Safecast/bGeigie-Raku/hardware/kicad/bGeigieRakuM5/M5_board.jpg

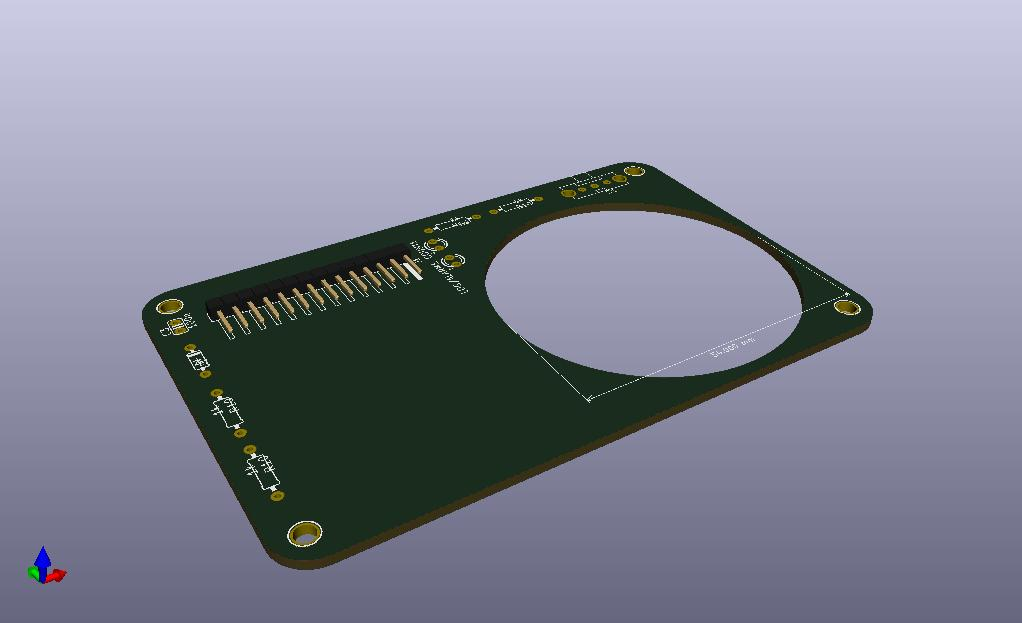
hardware/kicad/bGeigieRakuM5/M5_board.jpg
