Safecast/bGeigie-Raku/hardware/kicad/bGeigieRakuM5/M5_boardfire.png

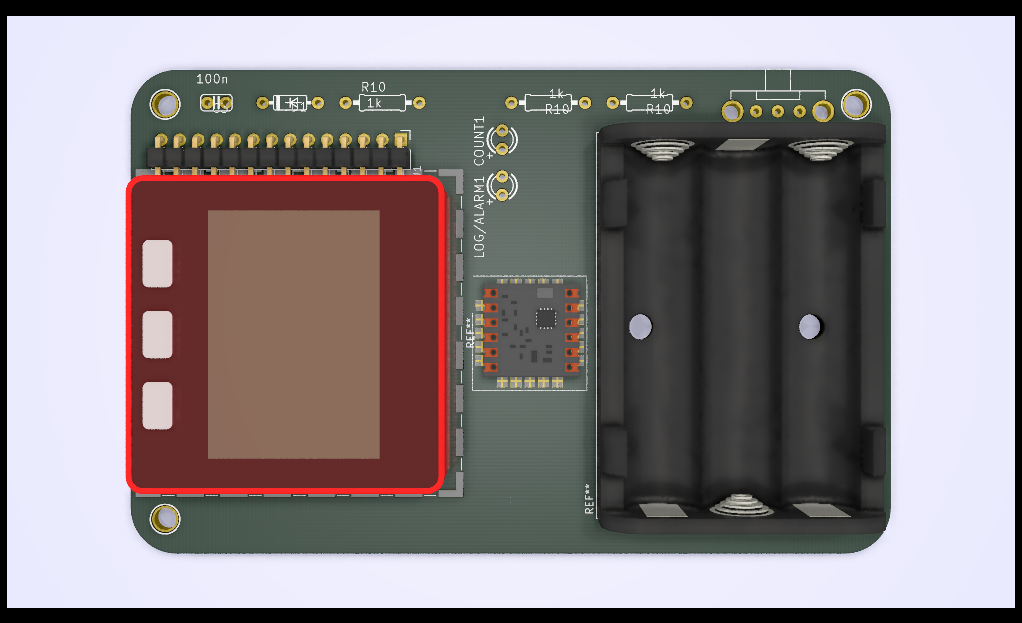
hardware/kicad/bGeigieRakuM5/M5_boardfire.png
