Safecast/bGeigie-Raku/hardware/kicad/bGeigieRakuM5/M5_board1.jpg

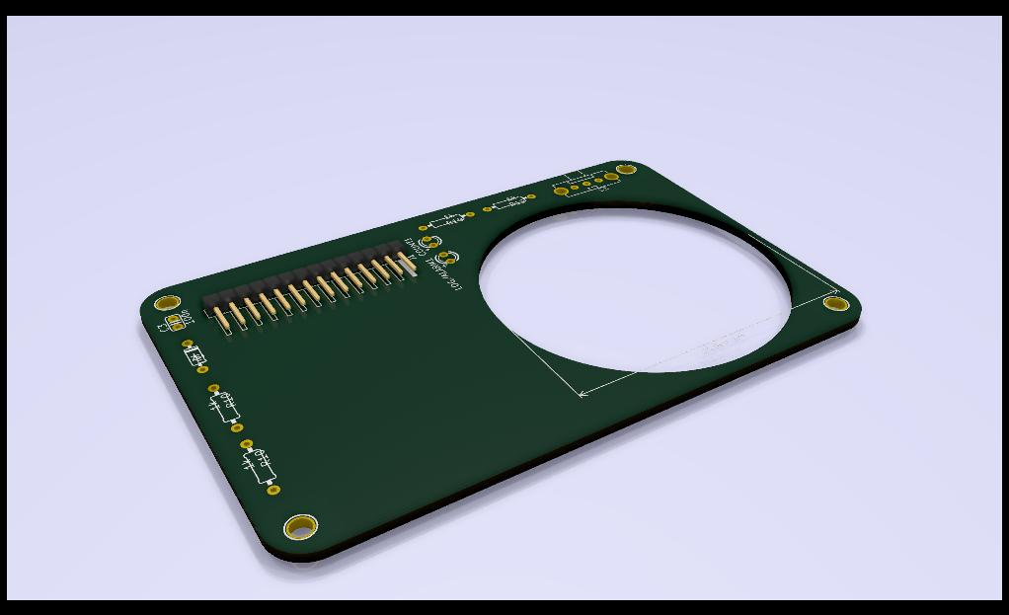
hardware/kicad/bGeigieRakuM5/M5_board1.jpg
