Safecast/bGeigie-Raku/hardware/kicad/bGeigieRakuM5/M5_board fire 1.jpg

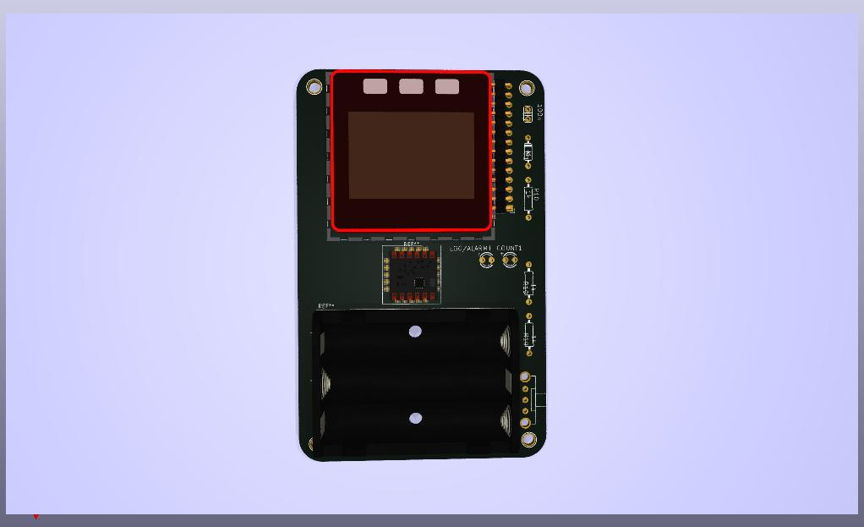
hardware/kicad/bGeigieRakuM5/M5_board fire 1.jpg
