Safecast/bGeigie-Raku/hardware/kicad/bGeigieRakuM5/M5_board fire.jpg

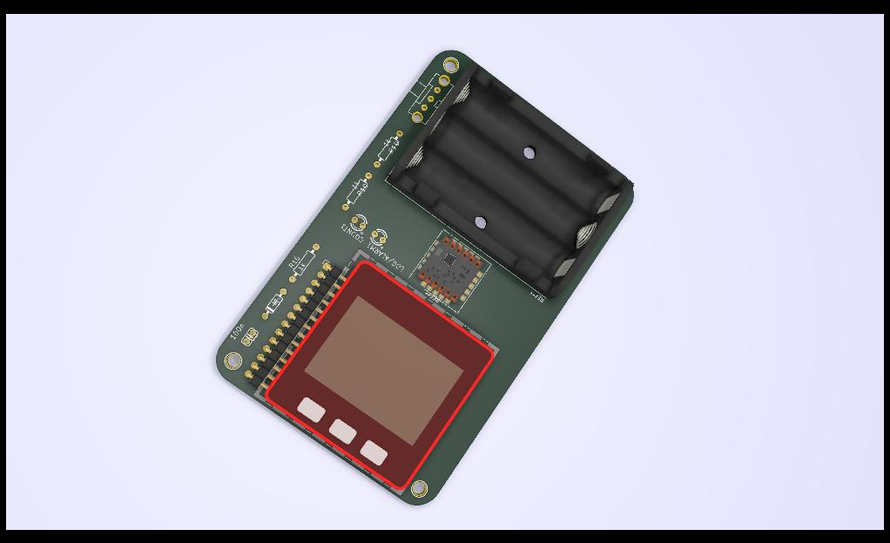
hardware/kicad/bGeigieRakuM5/M5_board fire.jpg
