Safecast/bGeigie-Raku/hardware/kicad/bGeigieRakuM5/M5_board_AAA.jpg

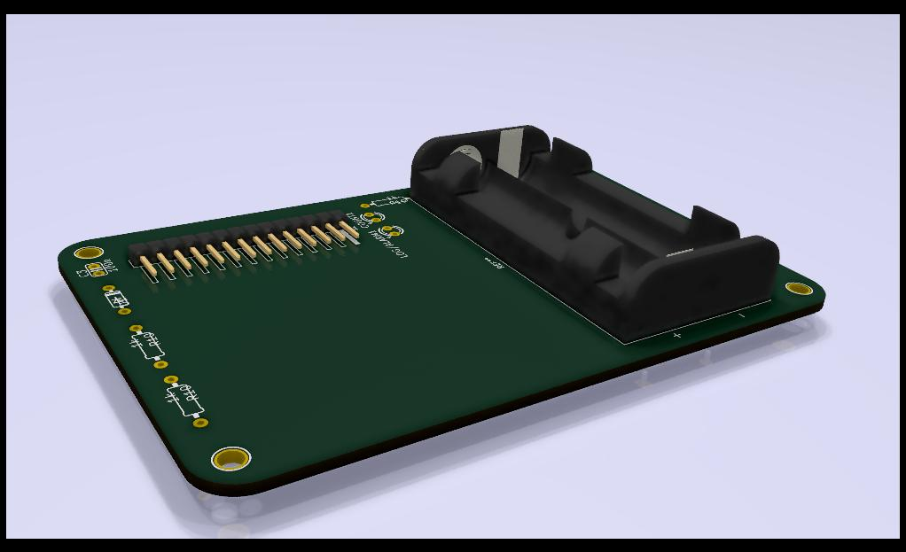
hardware/kicad/bGeigieRakuM5/M5_board_AAA.jpg
