Safecast/bGeigie-Raku/(threads)

Thread 13 (2021-03-20):

Message for terminal at startup

robouden, 2021-03-20:
Current firmware message at start up indicates a now existing config file?

_rst:0x1 (POWERON_RESET),boot:0x17 (SPI_FAST_FLASH_BOOT)
configsip: 0, SPIWP:0xee
clk_drv:0x00,q_drv:0x00,d_drv:0x00,cs0_drv:0x00,hd_drv:0x00,wp_drv:0x00
mode:DIO, clock div:2
load:0x3fff0018,len:4
load:0x3fff001c,len:1044
load:0x40078000,len:10124
load:0x40080400,len:5828
entry 0x400806a8
M5Stack initializing...O�␀Failed to read config from file_

Thread 15 (2021-04-04):

Battery level reading from LiPo

robouden, 2021-04-04:
Currently, the code from Robin is reading the status from the IP5306. But that is very primitive only 4 levels.
On the hardware side, G36 is connected the same way the bGeigieNano is connected.

A much nicer way for reading the correct voltage and the calculating the approximated charge would be much nicer.

robouden, 2023-03-13:
M5StackCore 2 modules fixes the issues with new power management chip.

Thread 23 (2022-03-10):

Setup WiFi and BLE connections a la bGeigieCast

robouden, 2022-03-10:
Needed for communication as fixed devices and for phones/tablet displaying the data.

Thread 26 (2022-03-26):

Check for movement detection on M5Stack Grey for dimming screen automatically to save power.

robouden, 2022-03-26:
For information about movement, detection:https://www.gwendesign.ch/kb/m5stack/m5stack/#wake-on-motion-wom-using-mpu6886-interrupt

robouden, 2022-03-26:
https://www.gwendesign.ch/kb/m5stack/m5stack/#wake-on-motion-wom-using-mpu6886-interrupt

Closed 2023-08-10.

Thread 27 (2023-03-09):

Cleanup old battery management source files, not relevant to M5 Core2

louisbertrand, 2023-03-09:
The file battery.cpp that defines the class BatteryMonitorIP5306 is no longer needed because M5 Core2 uses the AXP192 power management IC instead of the IP5306 the original M5 Core.
The Core2 library defines its own class AXP192, and there is an instance available to use in the m5 class. It builds, but may issue warnings about battery.cpp.
TODO: eventually simplify and remove battery.* from the build.

Thread 31 (2023-04-20):

Fix reset/power of standard (black/gray) M5Stack.

robouden, 2023-04-20:

Thread 32 (2023-06-08):

V3.0.0 board to be made/tested

robouden, 2023-06-08:
- [ ]  Layout changes for header placement with THT pins
- [ ]  No standoff holes
- [ ] Mount for tube improvement.
- [ ] Check safepulse mount pins
- [ ] test charger/battery layout

Closed 2023-08-14.

Thread 37 (2023-08-13):

File naming scheme for Drive and Journal

louisbertrand, 2023-08-13:
The file names should encode essential information to show status at a glance. The Core and Core2 API permit writing file names longer than the old DOS 8.3 constraint, and also create directories and subdirectories.
The information for Drive:
date-time started (first record written)
has it been submitted?
** what else? **

louisbertrand, 2023-08-21:
Existing bGeigie Nano file naming is
UUUUMMDD.LOG
where UUUU stands for the 4-digit device ID, and MMDD is 2-digit month and 2-digit day of the month. The year cannot be encoded in the file name, so logging on the same month/day in multiple years will append to the same file. A workaround is to mount the uSD card on a PC and archive the file after it has been submitted to the API. Manually move the latest files to a separate folder for each year.

louisbertrand, 2023-08-21:
Open questions:
If the file name must include date and time (e.g. ISO standard YYYY-MM-DDTHH:MM:SSZ), can a journal file be opened and named before getting a GPS fix?
Create a separate folder for each year?
What status needs to be encoded? New, Submitted, what else?

robouden, 2023-08-21:
> Existing bGeigie Nano file naming is UUUUMMDD.LOG where UUUU stands for the 4-digit device ID, and MMDD is 2-digit month and 2-digit day of the month. The year cannot be encoded in the file name, so logging on the same month/day in multiple years will append to the same file. A workaround is to mount the uSD card on a PC and archive the file after it has been submitted to the API. Manually move the latest files to a separate folder for each year.

The way that Robin worded around that is by creating year folders in the Zen..

Closed 2024-03-06.

Thread 39 (2023-08-13):

Can date-time be known before GPS ready?

louisbertrand, 2023-08-13:
It would be very convenient to begin journalling as soon as the system is started, but without date-time, it's hard to write reliable information.
Is there a real-time clock on the M5Stack Core and Core2?
Can the millis() be relied upon if the system sleeps? Is there an indication that a boot has occurred (cold boot, warm boot)?

louisbertrand, 2023-08-21:
The Core2 includes a RTC (NXP BM8563) with Arduino driver https://github.com/tanakamasayuki/I2C_BM8563
Unfortunately, the original Core does not.

robouden, 2023-08-21:
I checked the RTC is on the main board, not on the extension board:

From the M5Stack docs:
"There is a small expansion board on the back of the base with a 6-axis IMU sensor and microphone. There is a small expansion board on the back of the base with a 6-axis IMU sensor and microphone. "

louisbertrand, 2023-10-07:
For journalling purposes only, I propose to add an item in local storage for "last known date-time", to be updated at the same time as last_longitude and last_latitude. This last known date-time can be used as the file name for a new journal file on a cold start (no GNSS time known, and no realtime clock IC available.
The last known date-time can be kept in class LocalStorage (local_storage.h).
When the system boots, the journal file is created with a file name based on the last known date-time:
YYYY-MM-DD_HH-MM-SS_TEMP_JRNLTXT
Entries are timestamped with the millis() value.
When the correct time becomes available (GNSS), the journal file should be renamed. The renaming should be noted in the journal file so that older entries can be accurately back-dated based the milliseconds timestamps, relative to when the file was renamed.
The last known time is strictly for internal purposes; it would not be visible to the end user or logged to the map database.

BeakeS, 2023-10-07:
How can I purchase one of these kits?  The website store just hangs when I
try to checkout.

I could help with code development if I had the hardware.

Michael Beakes

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

louisbertrand, 2023-10-07:
Hi @BeakeS, the kits are still under development, with only a few prototypes available. Until I got mine, I just used the individual components on breadboards (M5Stack Core and Core2, BN-880 GPS). Without a GM tube, I just used an Arduino to provide pulses.
If you'd like to follow up, the best contact person is lead developer @robouden (Rob Oudendijk).

robouden, 2023-10-07:
@BeakeS

If you want, you can put in a custom order. Currently, we are just taken in orders. Not selling yet. Production is a work in progress. If you want to help with software development, please join our weekly meeting at:

Join Zoom Meeting
[https://us04web.zoom.us/j/3104600384?pwd=M2tZUGNWQll6aTJEMnByN1YxWUxrdz09](https://www.google.com/url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)

Meeting ID: 310 460 0384
Passcode: 9ZjWD6

Schedule is below:
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

robouden, 2023-10-07:
> I checked the RTC is on the main board, not on the extension board:
>
> From the M5Stack docs: "There is a small expansion board on the back of the base with a 6-axis IMU sensor and microphone. There is a small expansion board on the back of the base with a 6-axis IMU sensor and microphone. "

Great find. Did you check if it works?
!!!!!

louisbertrand, 2023-10-07:
Yes, the RTC works well. There is a "not initialized" bit that we can query, but it starts keeping time immediately even if the starting point is random after initial power up.

robouden, 2023-10-07:
And if the power is off, still on boot it has the correct time?

Regards,
Rob

On Sat, Oct 7, 2023 at 5:31 PM Louis Bertrand ***@***.***>
wrote:

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

louisbertrand, 2023-10-07:
Yup, battery backed up, but I need to confirm. I've had it powered off for a while, good opportunity to check.

robouden, 2023-10-07:
Seems you figured it out already

louisbertrand, 2023-10-07:
Yes, but also confirm on the actual prototype, with the external battery and charger.

robouden, 2023-10-09:
BeakeS,

If you send us your email, I can invite you for the Slack channel of bGeigieZen for software and hardware discussions.

Regards,
Rob Oudendijk

> How can I purchase one of these kits? The website store just hangs when I try to checkout. I could help with code development if I had the hardware. Michael Beakes
> […](#)
> On Sat, Oct 7, 2023, 03:47 Louis Bertrand ***@***.***> wrote: For journalling purposes only, I propose to add an item in local storage for "last known date-time", to be updated at the same time as last_longitude and last_latitude. This last known date-time can be used as the file name for a new journal file on a cold start (no GNSS time known, and no realtime clock IC available. The last known date-time can be kept in class LocalStorage (local_storage.h). When the system boots, the journal file is created with a file name based on the last known date-time: YYYY-MM-DD_HH-MM-SS_TEMP_JRNLTXT Entries are timestamped with the millis() value. When the correct time becomes available (GNSS), the journal file should be renamed. The renaming should be noted in the journal file so that older entries can be accurately back-dated based the milliseconds timestamps, relative to when the file was renamed. The last known time is strictly for internal purposes; it would not be visible to the end user or logged to the map database. — Reply to this email directly, view it on GitHub <[#39 (comment)](https://github.com/Safecast/bGeigieZen/issues/39#issuecomment-1751640641)>, or unsubscribe <https://github.com/notifications/unsubscribe-auth/AGT6W4NO5N2SV5DFJYKTOGLX6ECK7AVCNFSM6AAAAAA3OH55W6VHI2DSMVQWIX3LMV43OSLTON2WKQ3PNVWWK3TUHMYTONJRGY2DANRUGE> . You are receiving this because you are subscribed to this thread.Message ID: ***@***.***>

robouden, 2023-10-09:
BeakeS,

Interesting email address.
Noticed you have 0 repos on GitHub, are you new to GitHub?

Regards,
Rob Oudendijk

BeakeS, 2023-10-09:
Not new to github but not an expert either.  Had a different account/email
when I was a mentor for high school robotics teams.

Since I retired in 2021, I've been working on a lot of
microcontroller-based projects - mostly networked home sensor/control for
optimizing multi-zone hvac, water well monitoring, and security.  My son
has been bugging me for some time to push all my code off my linux box and
onto github.  No time like the present.

Michael

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

robouden, 2023-10-09:
BeakeS,

Thanks for the reply.
Better keep all your code on GitHub if you work in a team. So easy to roll
back, branch etc.

You want me to add you to the Safecast Slack channel?

Regards,
Rob Oudendijk

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

BeakeS, 2023-10-09:
Yes, please do.

Thanks,
Michael

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

robouden, 2023-10-09:
BeakeS,

Still need your email address.

Rob

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

BeakeS, 2023-10-09:
***@***.***

(I sent it when you first asked but changed the subject line.)

Thanks.

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

robouden, 2023-10-10:
Can you resend it to my email address below, or maybe better with Signal or
Keybase?

Regards,
Rob Oudendijk
https://yr-design.biz <http://yr-design.biz/>   https://oudendijk.biz
<http://oudendijk.biz/>  https://about.me/robouden
<http://about.me/robouden>tel +81 80-22605966  Skype: robouden  Facebook:
robouden <http://on.fb.me/QeKw2P> linkedin:robouden
<https://www.linkedin.com/in/roboudendijk>

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

Closed 2023-10-07.

Thread 40 (2023-08-22):

Cold and warm start of GPS

robouden, 2023-08-22:
After Azby did some testing I thought maybe his Zen did not get a first good lock and stayed in “cold start” mode.

Did we implement as on the Nano the following?:

For the bGeigieNano we use
#define PMTK_HOT_START "$PMTK101*32"
#define PMTK_COLD_START "$PMTK104*37"

More details at https://t.ly/CrOjC

louisbertrand, 2023-08-23:
I'm confused... Are these commands to send to the device? Or status sent by the device as it starts receiving GPS signals?
The TinyGPS++ API might offer that kind of detail.
Normally we would rely on the return values from isValid() and isUpdated(). However, you can define your own custom object `TinyGPSCustom` giving the sentence name and the field to watch. See the section "Differences from TinyGPS" in http://arduiniana.org/libraries/tinygpsplus/
I am going to try something like this, but I'm not sure what the parser will do with term number 0 (i.e. there are no data fields in this sentence, just the header followed by the checksum.
`TinyGPSCustom warmStart(gps, "PMTK102", 0);`

robouden, 2023-08-23:
Let us know the results.  The GPS should lock in a few seconds instead of 30 seconds or longer

louisbertrand, 2023-10-07:
After digging into how GNSS (Global Navigation Satellite Systems) work in general, and the u-blox M8 module in particular. we are stuck with long cold start times but shorter restart times.
There are multiple GNSS systems out there, and some augmentation methods to improve fix quality and acquisition times. GPS (NAVSTAR, USA) is the oldest and best known, but GLONASS (Russia) and Galileo (EU) are also available globally. In Asia, regional systems are available from China, Japan and India. Regional systems use specific orbits to keep satellites visible over their designated region. Geostationary satellites and terrestrial broadcasts linked to the global systems   improve fix acquisition time and quality.
Incidentally, smartphones can get their fix quickly because they get their ephemeris from the cellular phone provider.
In a cold start, the receiver has to wait until it has the almanac (orbit parameters) from the chosen constellation, up to 32 satellites, transmitted at 50bits/sec (yes, slow), then get precise ephemeris from each satellite in view. This can take up to 12 minutes for older receivers. Newer receivers read multiple channels concurrently and use augmentation systems for faster acquisition times, typically less than 4 minutes. The ability to use assistance systems depends on the receiver's location on the globe.
For a warm start, the receiver uses almanac stored in battery backed-up RAM (BBR) as "good enough for rock-n-roll" until the actual data catches up. The BBR data is good for up to 4 hours. After that, the time to a reliable fix is longer, though not as long as a cold start.
**Conclusion:** If the satellite almanac is unknown or stale, we can't get a fix any faster than what the receiver can get from the system. This would have to be pointed out in the user documentation so that a new user understands that the device is working correctly even if it doesn't get a fix immediately.
However, if we mistrust the fix, we have the option of forcing a cold start to discard discard the current almanac and ephemeris and reload from the system.

louisbertrand, 2023-10-07:
Correcting a misconception about warm-start vs. cold-start. Forcing a cold start is only relevant if we need to reload satellite almanac from scratch. Forcing a warm start only makes sense if the almanac is fresh (less than a few hours old).

Closed 2023-10-07.

Thread 45 (2024-03-06):

V4.x.x boards

robouden, 2024-03-06:
x [ ] dual 18500 batteries
x[ ] No power switch
x[ ] No 4056
- [ ] Safepulse only with two batteries or Irover with one battery
- [ ] V4.0.2 had ground issue and big plates for the 18650 clamps
- [ ] V4.0.3

Closed 2025-01-14.

Thread 50 (2024-04-05):

Automatic connect to open networks

robouden, 2024-04-05:
An option (maybe default if no SSID entry is in the setup made)  in real-time mode (fixed mode) an open, no password protected Wi-Fi network can be connected. I have seen this kind of setup on some IOT devices and I do consider that very useful. For the Zen in the mobile mode. More automatic is better!!!

Thread 61 (2024-04-26):

Cancel out of Settings > Options without changes

louisbertrand, 2024-04-26:
In the Settings > Options screen, there is no obvious way to cancel out and return to the main Settings screen. The workaround is to Enter Current settings, then press Menu.
There should be a "Cancel" option add to the end of the list.

Thread 63 (2024-04-28):

Question of new user to be discussed.

robouden, 2024-04-28:
1. When I switch on，how long does it take to warm up? Does it show it's ready like the Nano?

2. When to use cold start? How to use it best?

3. For survey mode
When Zen is INSIDE the case
I notice it is only about half the CPM displayed.
So you have preset Zen to cut out some CPM for survey mode?
How do you determine how much CPM to cut?
I want to amend because I notice it displays CP5s ...ie. counts per 5 seconds  instead of CPM as in drive mode

4. Still in survey mode,
Now I take zen OUTSIDE the case and put on the source I want to monitor.
The CPM I get is just the radiation emitted from the source. Correct?
You have programmed the ZEN to subtract out the ambient CPM??

5. For Settings...configure your device
We should not touch this. Correct?
When do we need to use it?

6. For debug info
What modules and data do I need to connect?

7. How long does the battery last after a full charging
8. At the bottom of the screen
Please explain the symbols
Info 79%
GM
GPS0
SD
WF
BT

Thread 64 (2024-04-28):

Question of new user to be discussed.

robouden, 2024-04-28:
1. When I switch on，how long does it take to warm up? Does it show it's ready like the Nano?

2. When to use cold start? How to use it best?

3. For survey mode
When Zen is INSIDE the case
I notice it is only about half the CPM displayed.
So you have preset Zen to cut out some CPM for survey mode?
How do you determine how much CPM to cut?
I want to amend because I notice it displays CP5s ...ie. counts per 5 seconds  instead of CPM as in drive mode

4. Still in survey mode,
Now I take zen OUTSIDE the case and put on the source I want to monitor.
The CPM I get is just the radiation emitted from the source. Correct?
You have programmed the ZEN to subtract out the ambient CPM??

5. For Settings...configure your device
We should not touch this. Correct?
When do we need to use it?

6. For debug info
What modules and data do I need to connect?

7. How long does the battery last after a full charging
8. At the bottom of the screen
Please explain the symbols
Info 79%
GM
GPS0
SD
WF
BT

robouden, 2024-04-28:
Some quick, simple answers:
1) It takes about a minute to do the first correct reading. For cold start to 1 minute an average is displayed.  The display will be showing yellow, orange data. After one minute, the data will be shown in white.
2) Cold start of the GPS or a cold start of the Zen?
3)Data is not changed if it is changed to different modes. Only the units are switched from CPM to uS/h (on V3.2.1). CP5 because it will not average the counts over one minute. Just every 5 seconds. A must for finding hotspot in survey mode.
4) You always read the background and the source.
5) The settings will be explained in the manual later. For the moment, do not change them.
6)Debug is only for displaying all the data. No need to connect anything.
7) battery should last about 16 hours (in my tests) and can be swapped, if the USB cable is connected to a power source, while the unit is running. With a OI changer, you can charge wireless while the unit is on.
8)Info
79%= battery level
GM=
GPS= number of satellites.
SD= in the sd card reading or writing (colors do change)
WF= WiFi mode
BT= blue tooth mode

Thread 66 (2024-05-02):

BN-880Q GPS module difficult to solder

louisbertrand, 2024-05-02:
On the Beitian BN-880Q GPS module, it is difficult to solder the header pins because the pads are thin and unplated. The solder does not flow easily onto the pads.
This will be a problem for inexperienced kit builders, where they could get an unreliable connection to the module, or no connection at all.

robouden, 2024-05-02:
Not sure what we should do. It will require more work for me.. I will think about it..

robouden, 2024-05-02:
I understand the idea.. :)

robouden, 2024-05-02:
There are BE-880Q (We have now BN-880Q) out, and I will check if they are better/easier to solder. That was a suggestion for Pieter in an email.

Thread 69 (2024-05-06):

Real-time: Send bulk measurements to the API

Claypuppet, 2024-05-06:
Current situation:
* At the time of sending, if the API times out / is not available, the measurement will be lost.

Idea:
Option to send bulk measurements to the API at once. This will help with the following
* missed measurement can be sent together with the next
* future optimization: send multiple measurements at once (e.g. once a minute)

robouden, 2024-05-06:
Found this:

https://github.com/Safecast/safecastapi/blob/6cf3612427b8d05c4855d491646f40da74a16987/app/views/home/show.html.erb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

Thread 71 (2024-05-18):

Add high current charging for Core 2

robouden, 2024-05-18:
Use M5.Axp.SetCHGCurrent(AXP192::kCHG_1320mA); for 1320mA charging on the USB-C connector.

louisbertrand, 2024-05-19:
Is fast charge necessary?
Realistically, how many pre-production Zens have AXP192? New CORE2 modules all have AXP2101.

robouden, 2024-05-19:
Fast charge is a requirement.!!!
But If we can not fast charge,  we can always exchange the empty battery
easy with a charged one.

On Mon, May 20, 2024 at 6:25 AM Louis Bertrand ***@***.***>
wrote:

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

Closed 2024-05-19.

Thread 72 (2024-05-19):

Define reqs for power mgmt v4.x boards

louisbertrand, 2024-05-19:
Define the requirements and follow-up design goals for the power management on v4.x boards: powering the device, charging the battery, power-on/power-off, protection.
DEFINITIONS (loosely based on AXP2101 terminology).
VBUS = 5V from USB charger
VSYS = System voltage for AXP2101
VBAT = Battery voltage
Other voltages mentioned are for internal use in CORE2 V1.1

GIVENS:
M5Stack CORE2 v1.1. The original CORE2 no longer available because the AXP192 PMIC was obsoleted by the manufacturer.
Single cell Li-Ion battery 18650 3.7V 18mm x 65 mm cylindrical form factor, capacities range up to 3400mAh

1- MUST HAVE
Reverse battery protection: against inserting battery in wrong polarity.
Over-voltage protection on VBAT.
Over-discharge protection
Over-charge protection for the battery
Charging without connecting USB cable: avoid connector point of failure.

2 - IMPORTANT TO HAVE
Low component count: cost, build complexity and, well, Zen.
No SMT soldering: easy for inexperienced kit builders (power device like DPAK or D2PAK would be OK).
Extended operating time between recharges; what is the target?
Remove power switch that was on v3.x boards
Charging without opening case, i.e. Qi charger

3 - NICE TO HAVE
Battery fast charge I(CH) > 300mA (AXP2101 default).
Control over power off: firmware read of CORE2 power button and control of power on/off through AXP2101 control register.

robouden, 2024-05-19:
The AXP2101 max charging is 100mA!!!

robouden, 2024-05-24:
Nice to have fast charging, still needs to be done..

Closed 2025-01-14.

Thread 73 (2024-05-20):

Cannot connect to local WiFi in Real-time mode

louisbertrand, 2024-05-20:
I cannot connect in real-time mode to the hotspot or to the local WiFi network.

Hardware CORE2 v1.1, running the updated firmware as of today May 20 (`23f5a8f8c1c14cd66cff0aeb73578ed245a44c29`)

The serial port log when entering Real-time mode:
```
New screen entered: Real-time
E (185365) wifi_init_default: netstack cb reg failed with 12308
WiFi connector: Trying to connect to wifi (Pixel_2172:zzzzzzzz)...
```
But the settings from the built-in AP and web server show the network name and password are correct.
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

I get the same when trying to connect to the local WiFi:
```
New screen entered: Real-time
E (832090) wifi_init_default: netstack cb reg failed with 12308
WiFi connector: Trying to connect to wifi (cavedweller:zzzzzzzz)...
```

Claypuppet, 2024-05-20:
The ESP32 can only connect to 2.4GHz networks, can you confirm the networks you tried to connect to are 2.4 and not 5GHz? Should probably be added in the manual too.

louisbertrand, 2024-05-20:
My phone only offers 5GHz??? That seems to be the problem. I'm closing it with a note to add to the documentation.

Closed 2024-05-20.

Thread 76 (2024-06-22):

Assembly Instructions nee

cyrusjk, 2024-06-22:
- Included items photo, upper right, between battery connectors and white 4 pin connector, item is unidentifiable and does not seem to be included or used.
- Do the 2 pairs of inboard pins for the 4056 charger need to divided, or can they remain connected as a pair? Would make assembly easier
- Instructions often mention flipping the board, but it is unclear which side of the board is being referred to, clarification is important here.
- There is no identification of + or - for the battery, and there are no clear directions, only that the + needs to be protected from grounding. This should be clearly printed on the board.
- White 4 pin connector has no documented purpose, but is part of the instructions to install, leaves the user feeling like they missed something. Should be better documented and/or optional.
- There should be a pre-flight test before securing the M4 and the tube to the board as it is difficult to make some fixes after. My GPS solder joints weren't good enough and I had to unscrew the m4 from behind the tube since it is now quite firmly attached. I ended up ditching the screws for now since the M4 is secure enough with the contact pins only.
- Cathode ground wire for tube does not reach the contact on the driver board, and needs to be bridged or replaced.
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
- While instructions say to affix the high voltage sticker, it doesn't say where and nothing is obvious. Only in a later photo do you see it, but it's not clear
- Contact charger seems superfluous, has no specs and blocks the USB C port for any other charging, should be documented and optional
- On Windows 11 additional drivers (CP210x_VCP_Windows) need to be installed, which are available from the same page as the burner, should be documented

Additionally, the font on the screen is TINY, about as small as could possibly be used on a screen of that resolution, and is unreadable except up close. Options for larger and/or simpler indicators should be provided

robouden, 2024-06-22:
Thanks for all the feedback. Some quick replies:

1. The white 4 pin connector is an extra I2C port to be used for other extra sensors if a user wants to use those. Not necessary for currently standard operation. In the next version of the board, we should maybe drop it, since not many people seem to be using it yet. If demand for it comes, we can always add it again.
2. On the 4056 board, the pinholes are not the standard distance between them. Not a 2.54 pitch.
3. Some tubes have shorter wires. We should include an extra wire extension wire and shrink tube with instructions on how to extend it.
4. Thanks for mentioning the CP210x_VCP_Windows installing is M5burner instructions are indeed missing on the M5burner page. We will make a link to them ([link](https://github.com/m5stack/m5-docs/blob/master/docs/en/related_documents/M5Burner.md))
5. The font is indeed a bit small. We did many tests and for most people the size of the fonts was acceptable. We had the main data as big as possible and easy to read. Maybe we should make an option to accommodate for people with less good vision.
6.

Closed 2025-01-14.

Thread 79 (2025-01-14):

No data shown in android app using bGeigie Zen

ZaphodBeeblebroxIV, 2025-01-14:
When using the android app (v0.5.0) it is possible to connect to the bGeigie Zen (v3.2.8) and the "BT" symbol turns green when pressing the connection button in the app. However, there is no data or map in the app. I have tried the same app on two different android devices (android 9 and android 14) with the same result.

robouden, 2025-01-14:
Bjorn,

Thank you for creating the issue.

Regards
Rob Oudendijk

ZaphodBeeblebroxIV, 2025-01-15:
I think the problem is in the app. I investigated this a bit and I downloaded the app "Serial Bluetooth Terminal 1.48". I used the information the file "bluetooth_settings.h" to create a profile and the I was able to use this app to connect to my bGeigie. I received the following data (note: I have obfuscated my position).
_18:28:45.631 Connecting to bGeigie5082 ...
18:28:46.970 Connected
18:28:47.308 $BNRDD,5082,2025‑01‑15T17:28:49Z,39,5,12662,A,5828.1234,N,1538.1234,E,37.0,A,7,346*42$BNRDD,5082,2025‑01‑15T17:28:54Z,41,4,12666,A,5828.1234,N,1538.1234,E,36.7,A,8,344*49$BNRDD,5082,2025‑01‑15T17:28:59Z,44,7,12673,A,5828.1234,N,1538.1234,E,38.3,A,9,254*41
18:29:19.877 Disconnected_
I compared the above information with Appendix A in the manual and it seems to be valid data.
Hence, the bGeigie works properly sending data and problem seems to be in the app.

robouden, 2025-01-15:
Zaphhod,

Thanks for checking this. The creator of the android app and the IOS map (two different creators) are both currently not available or not willing to fix the issues. For both  apps, we have the code available. I tried to rebuild the app, but I could not get it to build. If you want to try yourself, please let me know and we can collaborate to get it working. Would be great to get it fixed!!!

Warm regards,
Rob Oudendijk

robouden, 2025-01-15:
Zaphod,

The app is on [https://github.com/Safecast/Drive-android](https://github.com/Safecast/Drive-android)
For building [https://elafargue.github.io/wizkers-doc/building/](https://elafargue.github.io/wizkers-doc/building/)

Regards,
Rob Oudendijk
